brooklynresearch/EPCA/Models/EPCA Build.jpg

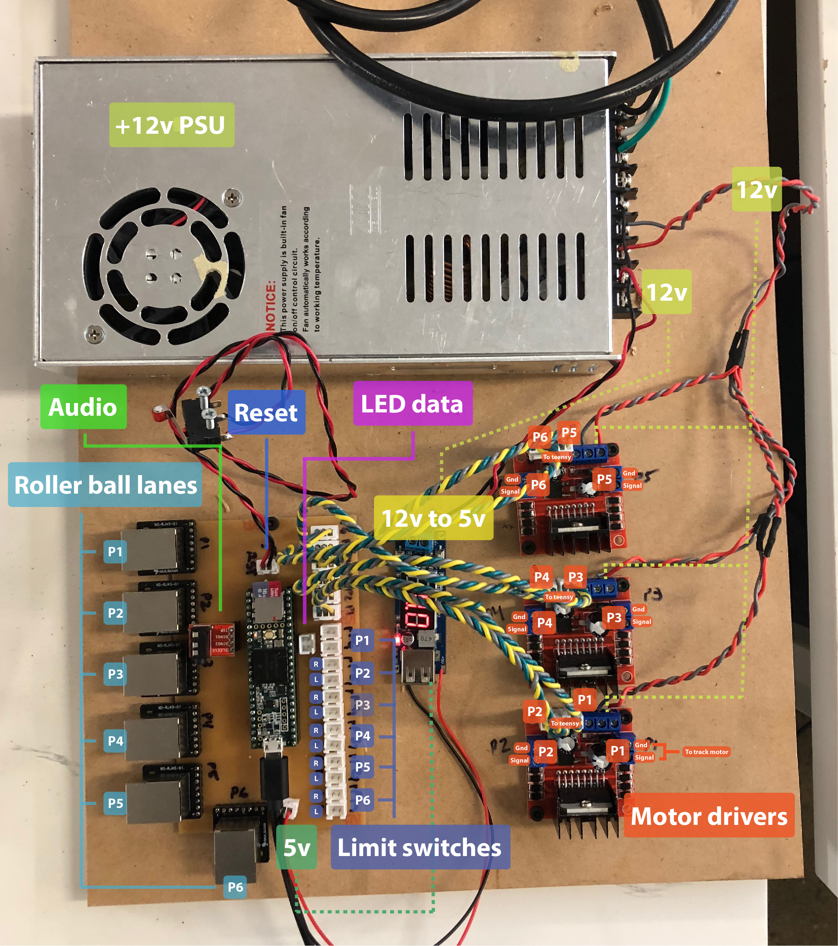
Models/EPCA Build.jpg
