brooklynresearch/EPCA/Models/IR Sensor - Right v10.stl

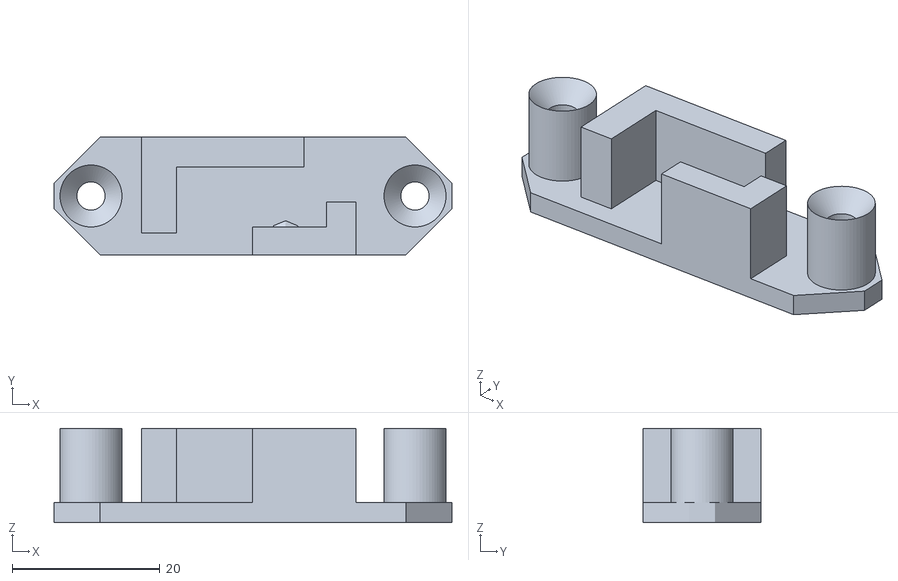
[picture p2: CAD file, 2019-09-24]
Models/IR Sensor - Right v10.stl
53.8 x 16.0 x 12.7
