brooklynresearch/EPCA/Models/IR Sensor - Left v7.stl

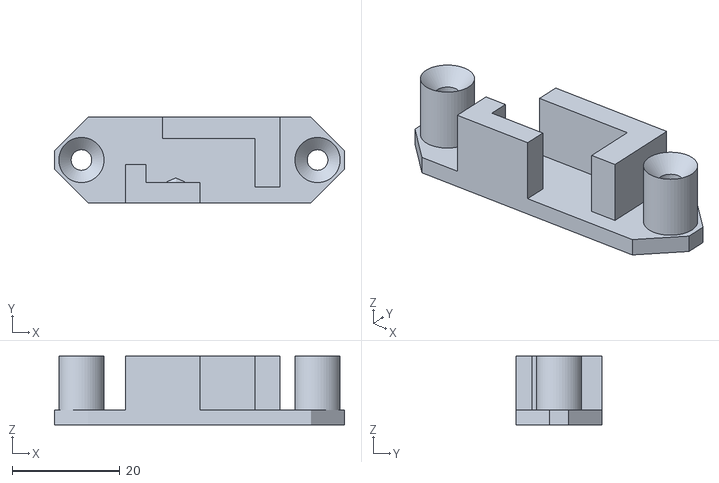
[picture p3: CAD file, 2019-09-24]
Models/IR Sensor - Left v7.stl
53.8 x 16.0 x 12.7
