brooklynresearch/EPCA/Models/Player Rod Celebrity Mount v4.stl

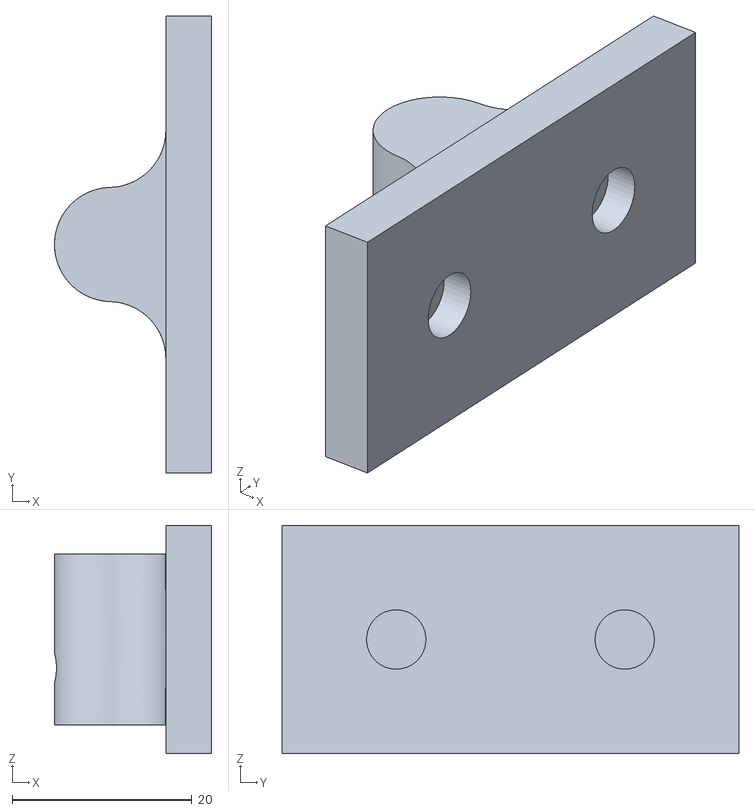
[picture p4: CAD file, 2019-09-16]
Models/Player Rod Celebrity Mount v4.stl
17.5 x 50.8 x 25.4
