brooklynresearch/EPCA/Models/Limit Switch Bracket v8.stl

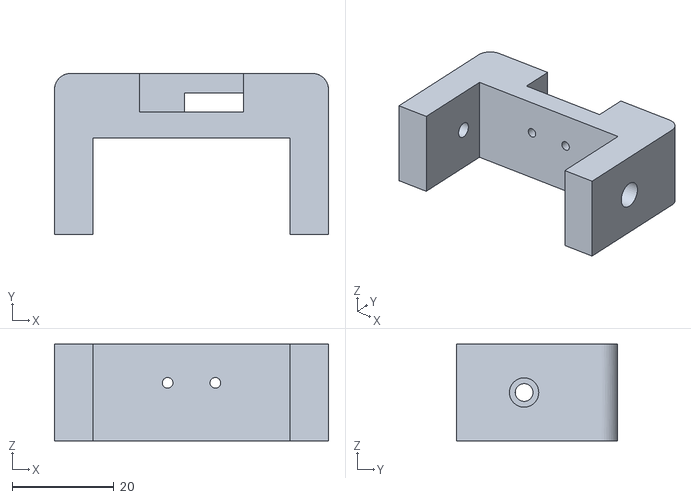
[picture p5: CAD file, 2019-09-11]
Models/Limit Switch Bracket v8.stl
54.0 x 31.8 x 19.0
