brooklynresearch/EPCA/Models/Player Rod Base Mount v9.stl

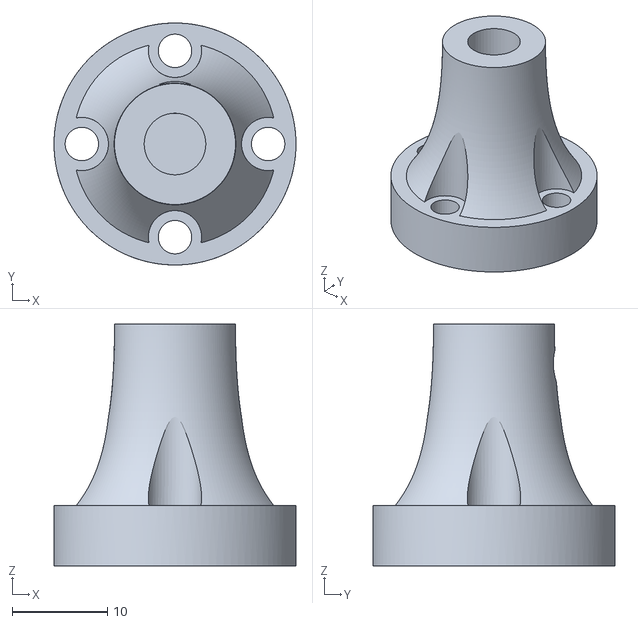
[picture p6: CAD file, 2019-09-11]
Models/Player Rod Base Mount v9.stl
25.4 x 25.4 x 25.4
