brooklynresearch/EPCA/Models/Wiring Overview.jpg

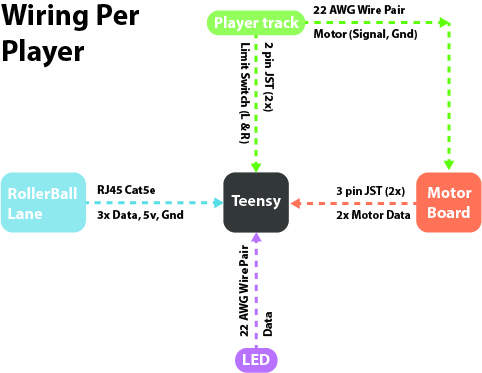
Models/Wiring Overview.jpg
