brooklynresearch/EPCA/Eagle/RollerBallRacerController.brd

## EAGLE design Eagle/RollerBallRacerController.brd (2019-10-17)

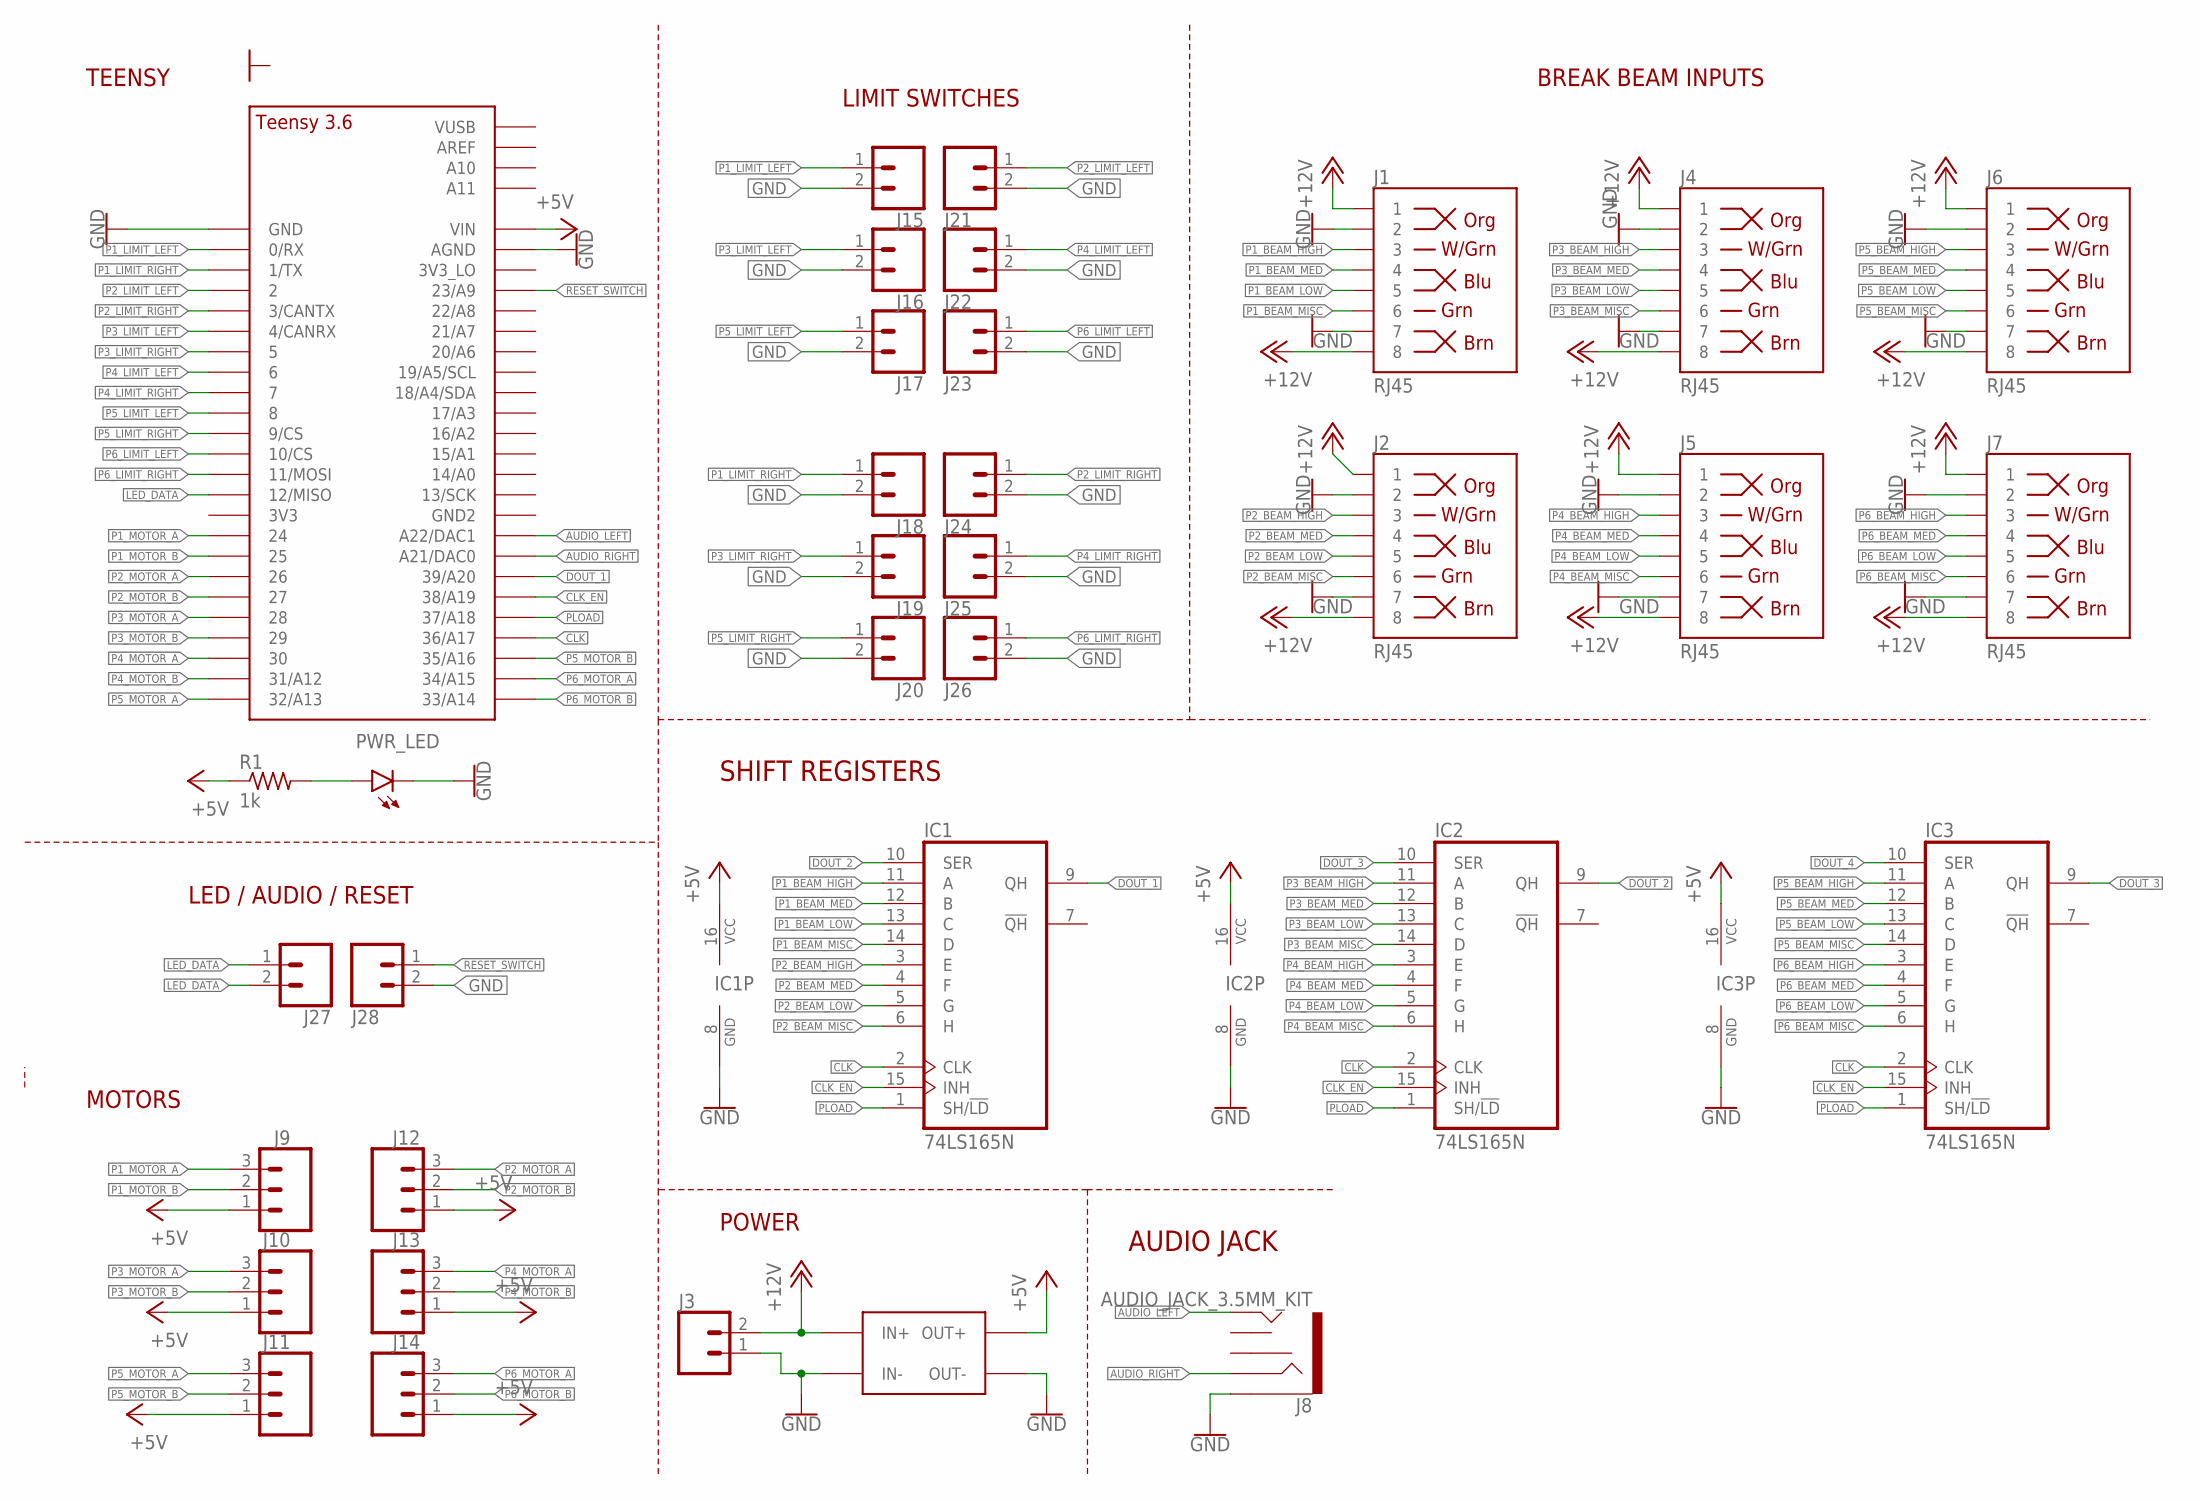
[picture p8: schematic RollerBallRacerController.sch]

Parts:
IC1, IC2, IC3: 74LS165N; DIL16
J1, J2, J4, J5, J6, J7: RJ45; RJ45-8
J3: CONN_025MM; SCREWTERMINAL-5MM-2
J8: AUDIO_JACK_3.5MM_KIT; AUDIO-JACK-KIT
J9, J10, J11, J12, J13, J14: CONN_03POLAR; MOLEX-1X3
J15, J16, J17, J18, J19, J20, J21, J22, J23, J24, J25, J26, J27, J28: CONN_02POLAR; MOLEX-1X2
PWR_LED: LED5MM
R1: 1k; 0204/7
U$2: LM2956_DC_DC; LM2596
U$3: TEENSY_3.5/3.6_BASIC

Connections:
+5V: IC1.16 (VCC), IC2.16 (VCC), IC3.16 (VCC), J9.1, J10.1, J11.1, J12.1, J13.1, J14.1, R1.1, U$2.P$4 (OUT+), U$3.VIN
+12V: J1.1, J1.8, J2.1, J2.8, J3.2, J4.1, J4.8, J5.1, J5.8, J6.1, J6.8, J7.1, J7.8, U$2.P$1 (IN+)
AUDIO_LEFT: J8.TIP, U$3.A22/DAC1
AUDIO_RIGHT: J8.RING, U$3.21/DAC0 (A21/DAC0)
CLK: IC1.2 (CLK), IC2.2 (CLK), IC3.2 (CLK), U$3.36/A17
CLK_EN: IC1.15 (INH), IC2.15 (INH), IC3.15 (INH), U$3.38/A19
DOUT_1: IC1.9 (QH), U$3.39/A20
DOUT_2: IC1.10 (SER), IC2.9 (QH)
DOUT_3: IC2.10 (SER), IC3.9 (QH)
DOUT_4: IC3.10 (SER)
GND: IC1.8 (GND), IC2.8 (GND), IC3.8 (GND), J1.2, J1.7, J2.2, J2.7, J3.1, J4.2, J4.7, J5.2, J5.7, J6.2, J6.7, J7.2, J7.7, J8.SLEEVE, J15.2, J16.2, J17.2, J18.2, J19.2, J20.2, J21.2, J22.2, J23.2, J24.2, J25.2, J26.2, J28.2, PWR_LED.K (C), U$2.P$2 (IN-), U$2.P$3 (OUT-), U$3.AGND, U$3.GND
LED_DATA: J27.1, J27.2, U$3.12/MISO
unnamed: PWR_LED.A, R1.2
P1_BEAM_HIGH: IC1.11 (A), J1.3
P1_BEAM_LOW: IC1.13 (C), J1.5
P1_BEAM_MED: IC1.12 (B), J1.4
P1_BEAM_MISC: IC1.14 (D), J1.6
P1_LIMIT_LEFT: J15.1, U$3.0/RX
P1_LIMIT_RIGHT: J18.1, U$3.1/TX
P1_MOTOR_A: J9.3, U$3.24
P1_MOTOR_B: J9.2, U$3.25
P2_BEAM_HIGH: IC1.3 (E), J2.3
P2_BEAM_LOW: IC1.5 (G), J2.5
P2_BEAM_MED: IC1.4 (F), J2.4
P2_BEAM_MISC: IC1.6 (H), J2.6
P2_LIMIT_LEFT: J21.1, U$3.2
P2_LIMIT_RIGHT: J24.1, U$3.3/CANTX
P2_MOTOR_A: J12.3, U$3.26
P2_MOTOR_B: J12.2, U$3.27
P3_BEAM_HIGH: IC2.11 (A), J4.3
P3_BEAM_LOW: IC2.13 (C), J4.5
P3_BEAM_MED: IC2.12 (B), J4.4
P3_BEAM_MISC: IC2.14 (D), J4.6
P3_LIMIT_LEFT: J16.1, U$3.4/CANRX
P3_LIMIT_RIGHT: J19.1, U$3.5
P3_MOTOR_A: J10.3, U$3.28
P3_MOTOR_B: J10.2, U$3.29
P4_BEAM_HIGH: IC2.3 (E), J5.3
P4_BEAM_LOW: IC2.5 (G), J5.5
P4_BEAM_MED: IC2.4 (F), J5.4
P4_BEAM_MISC: IC2.6 (H), J5.6
P4_LIMIT_LEFT: J22.1, U$3.6
P4_LIMIT_RIGHT: J25.1, U$3.7
P4_MOTOR_A: J13.3, U$3.30
P4_MOTOR_B: J13.2, U$3.31/A12
P5_BEAM_HIGH: IC3.11 (A), J6.3
P5_BEAM_LOW: IC3.13 (C), J6.5
P5_BEAM_MED: IC3.12 (B), J6.4
P5_BEAM_MISC: IC3.14 (D), J6.6
P5_LIMIT_LEFT: J17.1, U$3.8
P5_LIMIT_RIGHT: J20.1, U$3.9/CS
P5_MOTOR_A: J11.3, U$3.32/A13
P5_MOTOR_B: J11.2, U$3.35/A16
P6_BEAM_HIGH: IC3.3 (E), J7.3
P6_BEAM_LOW: IC3.5 (G), J7.5
P6_BEAM_MED: IC3.4 (F), J7.4
P6_BEAM_MISC: IC3.6 (H), J7.6
P6_LIMIT_LEFT: J23.1, U$3.10/CS
P6_LIMIT_RIGHT: J26.1, U$3.11/MOSI
P6_MOTOR_A: J14.3, U$3.34/A15
P6_MOTOR_B: J14.2, U$3.33/A14
PLOAD: IC1.1 (SH/!LD), IC2.1 (SH/!LD), IC3.1 (SH/!LD), U$3.37/A18
RESET_SWITCH: J28.1, U$3.23/A9

Notes on the sheet:
LIMIT SWITCHES
BREAK BEAM INPUTS
LED / AUDIO / RESET
POWER
MOTORS
TEENSY
AUDIO JACK
SHIFT REGISTERS

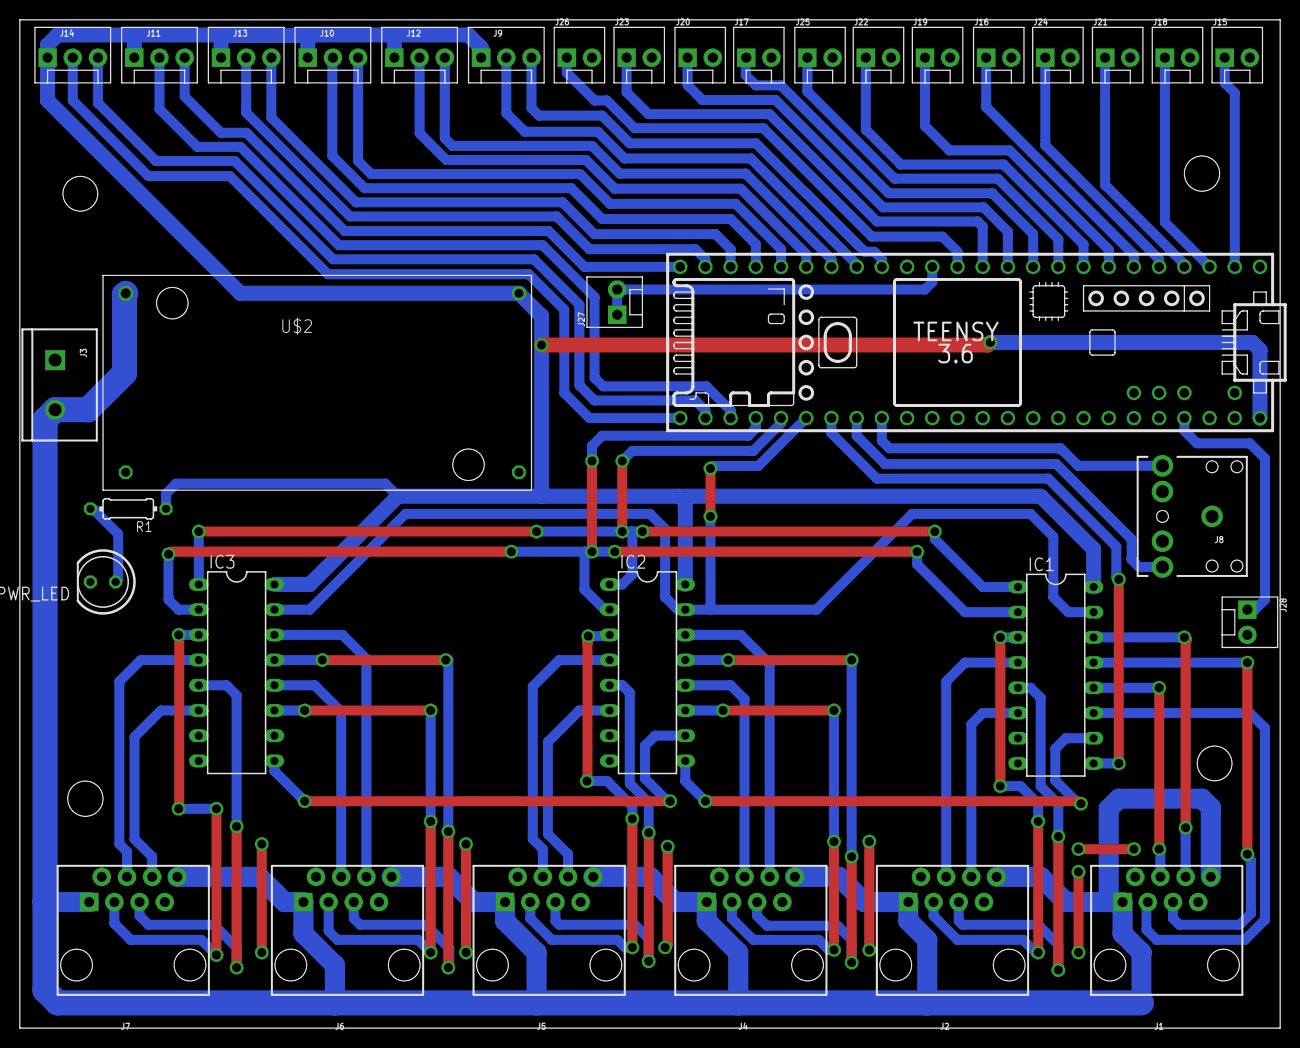
[picture p9: board RollerBallRacerController.brd from above]

Board: 2 copper layers, 127.0 x 101.6 mm, 35 parts (0 on the bottom side), 62 nets.
