brooklynresearch/EPCA/Eagle/IRSensorController.brd

## EAGLE design Eagle/IRSensorController.brd (2019-10-17)

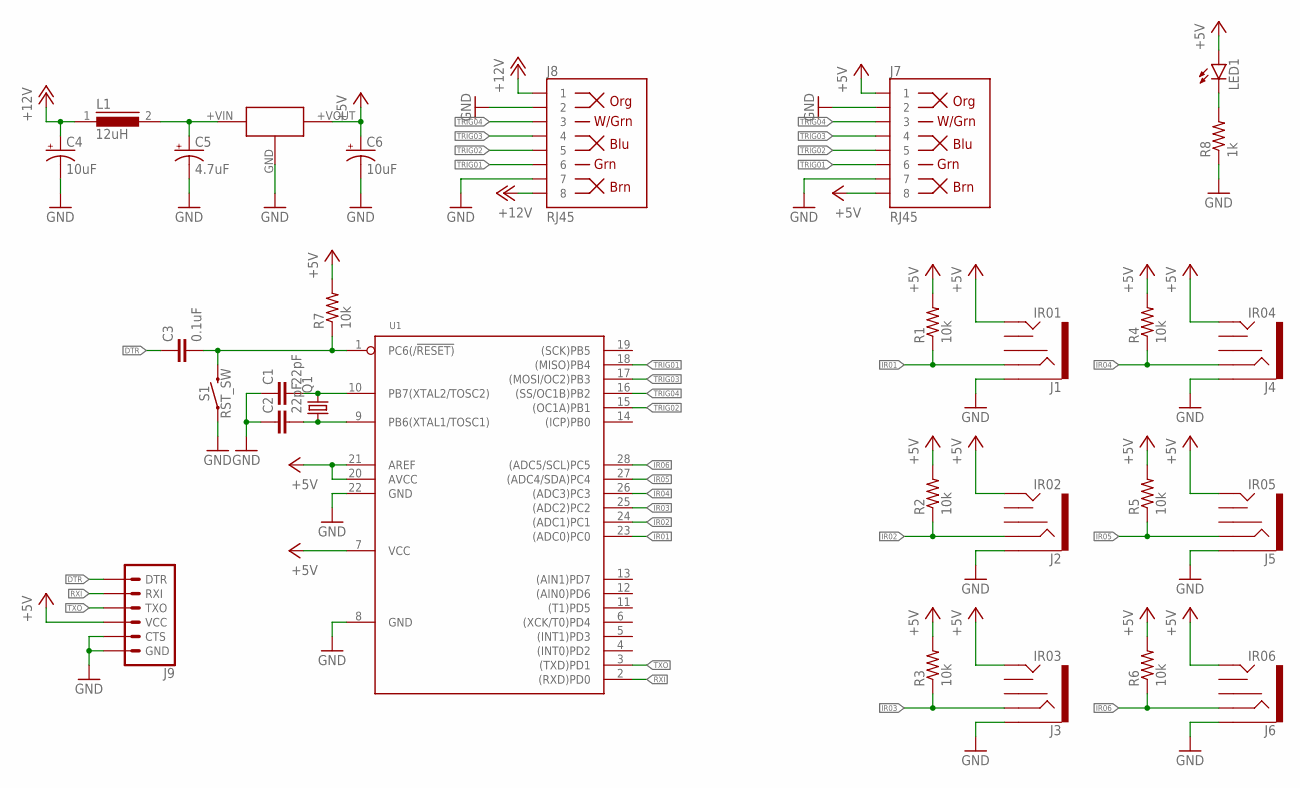
[picture p10: schematic IRSensorController.sch]

Parts:
C1, C2: 22pF; C050-025X075
C3: 0.1uF; C050-025X075
C4, C6: 10uF; E3,5-8
C5: 4.7uF; E2,5-7
J1: IR01; AUDIO-JACK-KIT
J2: IR02; AUDIO-JACK-KIT
J3: IR03; AUDIO-JACK-KIT
J4: IR04; AUDIO-JACK-KIT
J5: IR05; AUDIO-JACK-KIT
J6: IR06; AUDIO-JACK-KIT
J7, J8: RJ45; RJ45-8
J9: 6_PIN_SERIAL_TARGETSILK; 6_PIN_SERIAL_TARGET_SIDE_W_SILK
L1: 12uH; SUKW1-17
LED1: LED5MM
Q1: CRYSTALHC49S; HC49/S
R1, R2, R3, R4, R5, R6, R7: 10k; 0204/7
R8: 1k; 0204/7
S1: RST_SW; TACTILE_SWITCH_PTH_6.0MM
U1: MCU-ATMEGA328P-PU(DIP28); DIP28-2.54-34.7X7.62MM
U$1: R_78E_5V; R_78E

Connections:
+5V: C6.+, J1.TIP, J2.TIP, J3.TIP, J4.TIP, J5.TIP, J6.TIP, J7.1, J7.8, J9.P$4 (VCC), LED1.A, R1.2, R2.2, R3.2, R4.2, R5.2, R6.2, R7.2, U1.7 (VCC), U1.20 (AVCC), U1.21 (AREF), U$1.+VOUT
+12V: C4.+, J8.1, J8.8, L1.1
DTR: C3.1, J9.P$1 (DTR)
GND: C1.1, C2.1, C4.-, C5.-, C6.-, J1.SLEEVE, J2.SLEEVE, J3.SLEEVE, J4.SLEEVE, J5.SLEEVE, J6.SLEEVE, J7.2, J7.7, J8.2, J8.7, J9.P$5 (CTS), J9.P$6 (GND), R8.1, S1.1, U1.8 (GND), U1.22 (GND), U$1.GND
IR01: J1.RING, R1.1, U1.23 ((ADC0)PC0)
IR02: J2.RING, R2.1, U1.24 ((ADC1)PC1)
IR03: J3.RING, R3.1, U1.25 ((ADC2)PC2)
IR04: J4.RING, R4.1, U1.26 ((ADC3)PC3)
IR05: J5.RING, R5.1, U1.27 ((ADC4/SDA)PC4)
IR06: J6.RING, R6.1, U1.28 ((ADC5/SCL)PC5)
unnamed: C5.+, L1.2, U$1.+VIN
unnamed: LED1.K (C), R8.2
unnamed: C2.2, Q1.1, U1.9 (PB6(XTAL1/TOSC1))
unnamed: C1.2, Q1.2, U1.10 (PB7(XTAL2/TOSC2))
unnamed: C3.2, R7.1, S1.3 (2), U1.1 (PC6(/!RESET))
RXI: J9.P$3 (RXI), U1.2 ((RXD)PD0)
TRIG01: J7.6, J8.6, U1.18 ((MISO)PB4)
TRIG02: J7.5, J8.5, U1.15 ((OC1A)PB1)
TRIG03: J7.4, J8.4, U1.17 ((MOSI/OC2)PB3)
TRIG04: J7.3, J8.3, U1.16 ((SS/OC1B)PB2)
TXO: J9.P$2 (TXO), U1.3 ((TXD)PD1)

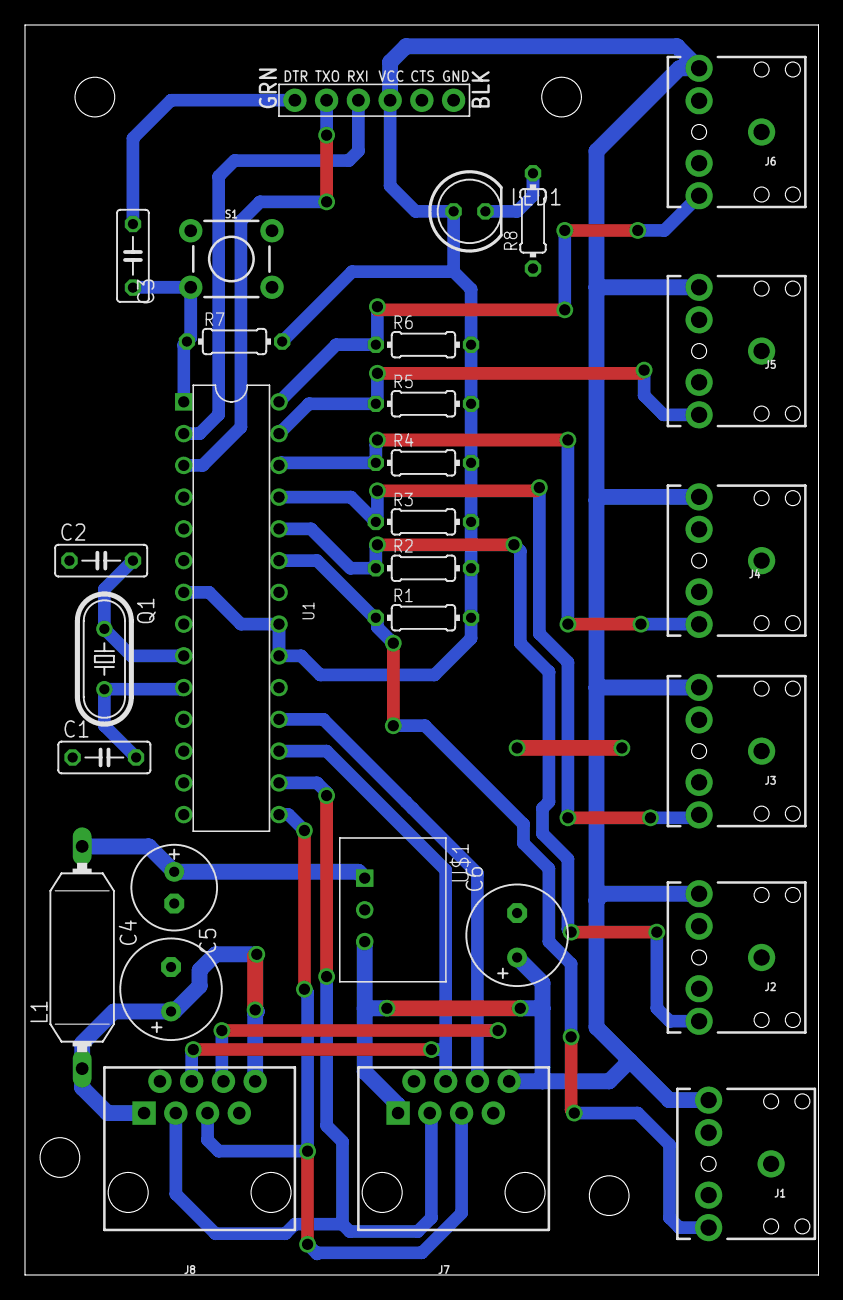
[picture p11: board IRSensorController.brd from above]

Board: 2 copper layers, 63.5 x 100.0 mm, 29 parts (0 on the bottom side), 21 nets.
