brooklynresearch/EPCA/(commit log)

2019-08-29 added prototype
2019-08-31 separated definitions, fix timing code
    [EPCA-prototype.ino, definitions.h]
2019-09-03 Added LED code, cycle through win sounds
2019-09-03 Added limit switch bracket model
    [Limit Switch Bracket v3.stl]
2019-09-03 Fixed bracket sides
    [Limit Switch Bracket v3.stl]
2019-09-08 motors running on 2 pin config, 3 sensors per player, updated 3D models
    [IR_Sensor_Left-small v3.stl, IR_Sensor_Right-small v3.stl, Limit Switch Bracket v3.stl, Limit Switch Bracket v5.stl, Player Rod Mount v4.stl]
2019-09-11 Added 1 line debug mode, updated motor timings, updated 3D models
    [Limit Switch Bracket v5.stl, Limit Switch Bracket v8.stl, Player Rod Base Mount v9.stl, Player Rod Celebrity Mount v3.stl, Player Rod Mount v4.stl]
2019-09-12 fixed light code, updated 3D models
    [IR Sensor - Left v5.stl, IR Sensor - Right v8.stl]
2019-09-16 Updated celebrity mount w/ magnets, changed light code for WS2815
    [Player Rod Celebrity Mount v3.stl, Player Rod Celebrity Mount v4.stl]
2019-09-24 Added eagle files, final code
    [IR Sensor - Left v5.stl, IR Sensor - Left v7.stl, IR Sensor - Right v10.stl, IR Sensor - Right v8.stl, IR_Sensor_Left-small v3.stl, IR_Sensor_Right-small v3.stl, Master.brd, Master.sch]
2019-09-25 Fixed limit switch pinout
    [definitions.h]
2019-09-25 fixed folder structure, updated pins
    [EPCA-final.ino, definitions.h]
2019-09-26 update traces on PCBs
2019-10-17 Mechanical Sensor Board and Code
    All new code and board designs for the mechanical sensors. These include the IR Controller, the Main Controller, and the new code associated with both. Plus the basic mount design for the Main Controller.
    [IRSensorController.brd, IRSensorController.sch, RollerBallRacerController.brd, RollerBallRacerController.sch]
